branchynski/Bjack_with_gesture_control/model/matrix.png

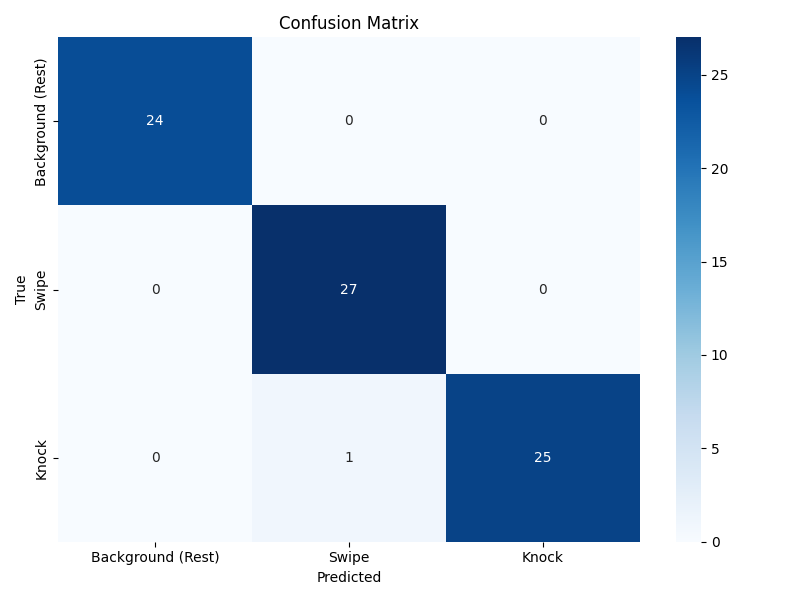
model/matrix.png
