branchynski/Bjack_with_gesture_control/model/ai_sensor_model/doc/ReleaseNotes.txt

Family       : artix7
Device       : xc7a35t
Package      : -cpg236
Speed Grade  : -1
Clock Period : 15.385
