branchynski/Bjack_with_gesture_control/rtl/ai/ml_sensor.v

// (c) Copyright 1986-2022 Xilinx, Inc. All Rights Reserved.
// (c) Copyright 2022-2026 Advanced Micro Devices, Inc. All rights reserved.
// 
// This file contains confidential and proprietary information
// of AMD and is protected under U.S. and international copyright
// and other intellectual property laws.
// 
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
// CRITICAL APPLICATIONS
// AMD products are not designed or intended to be fail-
// safe, or for use in any application requiring fail-safe
// performance, such as life-support or safety devices or
// systems, Class III medical devices, nuclear facilities,
// applications related to the deployment of airbags, or any
// other applications that could lead to death, personal
// injury, or severe property or environmental damage
// (individually and collectively, "Critical
// Applications"). Customer assumes the sole risk and
// liability of any use of AMD products in Critical
// Applications, subject only to applicable laws and
// regulations governing limitations on product liability.
// 
// THIS COPYRIGHT NOTICE AND DISCLAIMER MUST BE RETAINED AS
// PART OF THIS FILE AT ALL TIMES.
// 
// DO NOT MODIFY THIS FILE.


// IP VLNV: Bartlomiej_Raczynski:hls:myproject:1.0
// IP Revision: 2114630688

(* X_CORE_INFO = "myproject,Vivado 2025.1" *)
(* CHECK_LICENSE_TYPE = "ML_sensor,myproject,{}" *)
(* IP_DEFINITION_SOURCE = "HLS" *)
(* DowngradeIPIdentifiedWarnings = "yes" *)
module ML_sensor (
  input_layer_TDATA,
  input_layer_TREADY,
  input_layer_TVALID,
  layer15_out_TDATA,
  layer15_out_TREADY,
  layer15_out_TVALID,
  ap_clk,
  ap_rst_n,
  ap_done,
  ap_idle,
  ap_ready,
  ap_start
);

(* X_INTERFACE_INFO = "xilinx.com:interface:axis:1.0 input_layer TDATA" *)
(* X_INTERFACE_MODE = "slave" *)
(* X_INTERFACE_PARAMETER = "XIL_INTERFACENAME input_layer, TUSER_WIDTH 0, TDATA_NUM_BYTES 12, TDEST_WIDTH 0, TID_WIDTH 0, HAS_TREADY 1, HAS_TSTRB 0, HAS_TKEEP 0, HAS_TLAST 0, FREQ_HZ 100000000, PHASE 0.0, LAYERED_METADATA undef, INSERT_VIP 0" *)
input wire [95 : 0] input_layer_TDATA;
(* X_INTERFACE_INFO = "xilinx.com:interface:axis:1.0 input_layer TREADY" *)
output wire input_layer_TREADY;
(* X_INTERFACE_INFO = "xilinx.com:interface:axis:1.0 input_layer TVALID" *)
input wire input_layer_TVALID;
(* X_INTERFACE_INFO = "xilinx.com:interface:axis:1.0 layer15_out TDATA" *)
(* X_INTERFACE_MODE = "master" *)
(* X_INTERFACE_PARAMETER = "XIL_INTERFACENAME layer15_out, TUSER_WIDTH 0, TDATA_NUM_BYTES 6, TDEST_WIDTH 0, TID_WIDTH 0, HAS_TREADY 1, HAS_TSTRB 0, HAS_TKEEP 0, HAS_TLAST 0, FREQ_HZ 100000000, PHASE 0.0, LAYERED_METADATA undef, INSERT_VIP 0" *)
output wire [47 : 0] layer15_out_TDATA;
(* X_INTERFACE_INFO = "xilinx.com:interface:axis:1.0 layer15_out TREADY" *)
input wire layer15_out_TREADY;
(* X_INTERFACE_INFO = "xilinx.com:interface:axis:1.0 layer15_out TVALID" *)
output wire layer15_out_TVALID;
(* X_INTERFACE_INFO = "xilinx.com:signal:clock:1.0 ap_clk CLK" *)
(* X_INTERFACE_MODE = "slave" *)
(* X_INTERFACE_PARAMETER = "XIL_INTERFACENAME ap_clk, ASSOCIATED_BUSIF input_layer:layer15_out, ASSOCIATED_RESET ap_rst_n, FREQ_HZ 100000000, FREQ_TOLERANCE_HZ 0, PHASE 0.0, INSERT_VIP 0" *)
input wire ap_clk;
(* X_INTERFACE_INFO = "xilinx.com:signal:reset:1.0 ap_rst_n RST" *)
(* X_INTERFACE_MODE = "slave" *)
(* X_INTERFACE_PARAMETER = "XIL_INTERFACENAME ap_rst_n, POLARITY ACTIVE_LOW, INSERT_VIP 0" *)
input wire ap_rst_n;
(* X_INTERFACE_INFO = "xilinx.com:interface:acc_handshake:1.0 ap_ctrl done" *)
(* X_INTERFACE_MODE = "slave" *)
output wire ap_done;
(* X_INTERFACE_INFO = "xilinx.com:interface:acc_handshake:1.0 ap_ctrl idle" *)
output wire ap_idle;
(* X_INTERFACE_INFO = "xilinx.com:interface:acc_handshake:1.0 ap_ctrl ready" *)
output wire ap_ready;
(* X_INTERFACE_INFO = "xilinx.com:interface:acc_handshake:1.0 ap_ctrl start" *)
input wire ap_start;

(* SDX_KERNEL = "true" *)
(* SDX_KERNEL_TYPE = "hls" *)
(* SDX_KERNEL_SYNTH_INST = "inst" *)
  myproject inst (
    .input_layer_TDATA(input_layer_TDATA),
    .input_layer_TREADY(input_layer_TREADY),
    .input_layer_TVALID(input_layer_TVALID),
    .layer15_out_TDATA(layer15_out_TDATA),
    .layer15_out_TREADY(layer15_out_TREADY),
    .layer15_out_TVALID(layer15_out_TVALID),
    .ap_clk(ap_clk),
    .ap_rst_n(ap_rst_n),
    .ap_done(ap_done),
    .ap_idle(ap_idle),
    .ap_ready(ap_ready),
    .ap_start(ap_start)
  );
endmodule
