branchynski/Bjack_with_gesture_control/rtl/bjack_fsm/bjack_datapath.sv

/********************************************************************************
 * Module Name:    bjack_datapath
 * Date:           2026-06-04
 * Version:        2.1 (Master/Slave Massive-IF Architecture)
 * Description:    
 * Main datapath for the Blackjack game. 
 * If is_master == 1: Requests cards from LFSR, controls flow.
 * If is_master == 0: Passively accepts cards from UART and renders them.
 ********************************************************************************/

 module bjack_datapath (
    input  logic clk,
    input  logic rst_n,
    
    // --- OPERATING MODE SELECTION ---
    input  logic is_master,

    // --- Control signals from local FSM (Master only) ---
    input  logic sig_deal_enable, 
    input  logic sig_p0_turn,     
    input  logic sig_p1_turn,     
    input  logic sig_dealer_turn, 
    input  logic btn_p0_hit,      
    input  logic btn_p1_hit,      
    input  logic btn_start,       

    // --- Feedback signals to local FSM (Master only) ---
    output logic p0_bust,         
    output logic p1_bust,         
    output logic deal_done,
    output logic dealer_done,

    // --- Connection to local LFSR (Master only) ---
    input  logic [5:0] card_value,
    input  logic card_valid,
    output logic card_req,
    
    // --- Passive UART inputs (Slave only) ---
    input  logic uart_card_valid,
    input  logic [5:0] uart_card_val,
    input  logic [1:0] uart_card_dst, 
    input  logic uart_new_game,       

    // --- VGA Connection (Common) ---
    output logic [5:0] p0_cards [0:4],
    output logic [5:0] p1_cards [0:4],
    output logic [5:0] dealer_cards [0:4],
    output logic [2:0] p0_card_cnt,
    output logic [2:0] p1_card_cnt,
    output logic [2:0] dealer_card_cnt
);

    timeunit 1ns;
    timeprecision 1ps;

    import bjack_pkg::*;

    logic [2:0] init_deal_step; 
    logic req_pending;          
    
    // Final scores and Ace flags
    logic [5:0] p0_score, p1_score, d_score;
    logic p0_has_ace, p1_has_ace, d_has_ace;

    
    // EDGE DETECTORS 
    logic btn_p0_hit_prev, btn_p1_hit_prev;
    logic p0_hit_pulse, p1_hit_pulse;

    always_ff @(posedge clk or negedge rst_n) begin
        if (!rst_n) begin
            btn_p0_hit_prev <= 1'b0;
            btn_p1_hit_prev <= 1'b0;
        end else begin
            btn_p0_hit_prev <= btn_p0_hit;
            btn_p1_hit_prev <= btn_p1_hit;
        end
    end

    
    assign p0_hit_pulse = btn_p0_hit && !btn_p0_hit_prev;
    assign p1_hit_pulse = btn_p1_hit && !btn_p1_hit_prev;


    function automatic logic [3:0] get_points(input logic [5:0] c_val);
        logic [3:0] rank;
        rank = c_val % 13;
        if (rank == 0) return 4'd11;           
        else if (rank > 0 && rank < 10) return rank + 1; 
        else return 4'd10;                     
    endfunction

    always_ff @(posedge clk or negedge rst_n) begin
        if (!rst_n) begin
            p0_card_cnt <= '0;
            p1_card_cnt <= '0;
            dealer_card_cnt <= '0;
            init_deal_step  <= '0;
            card_req        <= 1'b0;
            req_pending     <= 1'b0;
            p0_bust         <= 1'b0;
            p1_bust         <= 1'b0;
            deal_done       <= 1'b0;
            dealer_done     <= 1'b0;
            
            for (int i=0; i<5; i++) begin
                p0_cards[i] <= '0;
                p1_cards[i] <= '0;
                dealer_cards[i] <= '0;
            end
        end else begin
            if (btn_start || (!is_master && uart_new_game)) begin
                p0_card_cnt <= '0;
                p1_card_cnt <= '0;
                dealer_card_cnt <= '0;
                init_deal_step  <= '0;
                p0_bust         <= 1'b0;
                p1_bust         <= 1'b0;
                deal_done       <= 1'b0;
                dealer_done     <= 1'b0;
                req_pending     <= 1'b0;
            end

            card_req <= 1'b0; 

            if (is_master) begin
                // --- 1. DEALING PHASE ---
                if (sig_deal_enable && !deal_done) begin
                    if (!req_pending && init_deal_step < 6) begin
                        card_req <= 1'b1;
                        req_pending <= 1'b1;
                    end
                    
                    if (card_valid && req_pending) begin
                        req_pending <= 1'b0;
                        if (init_deal_step == 0 || init_deal_step == 3) begin
                            p0_cards[p0_card_cnt] <= card_value; p0_card_cnt <= p0_card_cnt + 1;
                        end else if (init_deal_step == 1 || init_deal_step == 4) begin
                            p1_cards[p1_card_cnt] <= card_value; p1_card_cnt <= p1_card_cnt + 1;
                        end else begin
                            dealer_cards[dealer_card_cnt] <= card_value; dealer_card_cnt <= dealer_card_cnt + 1;
                        end
                        init_deal_step <= init_deal_step + 1;
                    end
                    if (init_deal_step == 6) deal_done <= 1'b1;
                end

                // --- 2. PLAYER 0 TURN ---
                if (sig_p0_turn) begin
                    if (p0_hit_pulse && !req_pending && p0_card_cnt < 5) begin
                        card_req <= 1'b1; req_pending <= 1'b1;
                    end
                    if (card_valid && req_pending) begin
                        req_pending <= 1'b0; p0_cards[p0_card_cnt] <= card_value; p0_card_cnt <= p0_card_cnt + 1;
                    end
                    if (p0_score > 21) p0_bust <= 1'b1;
                end

                // --- 3. PLAYER 1 TURN ---
                if (sig_p1_turn) begin
                    if (p1_hit_pulse && !req_pending && p1_card_cnt < 5) begin
                        card_req <= 1'b1; req_pending <= 1'b1;
                    end
                    if (card_valid && req_pending) begin
                        req_pending <= 1'b0; p1_cards[p1_card_cnt] <= card_value; p1_card_cnt <= p1_card_cnt + 1;
                    end
                    
                    if (p1_score > 21) p1_bust <= 1'b1;
                end

                // --- 4. DEALER TURN ---
                if (sig_dealer_turn && !dealer_done) begin
                    if (d_score < 17 && dealer_card_cnt < 5) begin
                        if (!req_pending) begin
                            card_req <= 1'b1; req_pending <= 1'b1;
                        end
                        if (card_valid && req_pending) begin
                            req_pending <= 1'b0; dealer_cards[dealer_card_cnt] <= card_value; dealer_card_cnt <= dealer_card_cnt + 1;
                        end
                    end else if (!req_pending) begin 
                        dealer_done <= 1'b1;
                    end
                end

            end else begin
                // --- SLAVE MODE ---
                card_req <= 1'b0;
                req_pending <= 1'b0;
                
                if (uart_card_valid) begin
                    case (uart_card_dst)
                        2'd0: begin if (p0_card_cnt < 5) begin p0_cards[p0_card_cnt] <= uart_card_val; p0_card_cnt <= p0_card_cnt + 1; end end
                        2'd1: begin if (p1_card_cnt < 5) begin p1_cards[p1_card_cnt] <= uart_card_val; p1_card_cnt <= p1_card_cnt + 1; end end
                        2'd2: begin if (dealer_card_cnt < 5) begin dealer_cards[dealer_card_cnt] <= uart_card_val; dealer_card_cnt <= dealer_card_cnt + 1; end end
                    endcase
                end
            end
        end
    end

   
    // Immediate Point Calculation
    logic [5:0] p0_raw, p1_raw, d_raw;
    
    always_comb begin
        p0_raw = '0; p0_has_ace = 1'b0;
        p1_raw = '0; p1_has_ace = 1'b0;
        d_raw = '0;  d_has_ace = 1'b0;

        for (int i = 0; i < 5; i++) begin
            if (i < p0_card_cnt) begin
                p0_raw = p0_raw + get_points(p0_cards[i]);
                if (p0_cards[i] % 13 == 0) p0_has_ace = 1'b1;
            end
            if (i < p1_card_cnt) begin
                p1_raw = p1_raw + get_points(p1_cards[i]);
                if (p1_cards[i] % 13 == 0) p1_has_ace = 1'b1;
            end
            if (i < dealer_card_cnt) begin
                d_raw = d_raw + get_points(dealer_cards[i]);
                if (dealer_cards[i] % 13 == 0) d_has_ace = 1'b1;
            end
        end

        // HARDWARE MULTIPLEXER: Changing Ace value on the fly
        p0_score = (p0_has_ace && p0_raw > 21) ? p0_raw - 10 : p0_raw;
        p1_score = (p1_has_ace && p1_raw > 21) ? p1_raw - 10 : p1_raw;
        d_score  = (d_has_ace  && d_raw  > 21) ? d_raw  - 10 : d_raw;
    end

endmodule
