branchynski/Bjack_with_gesture_control/rtl/gesture_monitor.sv

/**
 * Module name:   gesture_monitor
 * Author:        Bartłomiej Raczyński
 * Version:       1.0
 * Last modified: 2026-06-07
 * Description:  module for monitoring the output of the gesture recognition system. 
 * It takes the current gesture as input and drives a set of LEDs to 
 * indicate which gesture is currently recognized. 
 */

import ai_type_pkg::*;

module gesture_monitor (
    input  logic clk,
    input  logic rst_n,
    input  gesture_out current_gesture,

    output logic [2:0] leds
);

    logic [2:0] leds_nxt;

    always_ff @(posedge clk or negedge rst_n) begin
        if (!rst_n) begin
            leds <= '0;
        end else begin
            leds <= leds_nxt;
        end
    end

    always_comb begin
        case (current_gesture)
            NOTHING:       leds_nxt = 3'b001;
            SWIPE_RIGHT: leds_nxt = 3'b010;
            KNOCK:  leds_nxt = 3'b100;
            default:     leds_nxt = 3'b000;
        endcase
    end

endmodule
