branchynski/Bjack_with_gesture_control/rtl/bjack_fsm/bjack_pkg.sv

/********************************************************************************
 * Package Name:   bjack_pkg
 * Author:         Eryk Rutka
 * Date:           2026-06-02
 * Version:        1.2 (Multiplayer Update)
 * * Description:   
 * This package contains data types, parameters for card game.
 ********************************************************************************/

 package bjack_pkg;

    /* bjack_fsm  */
        typedef enum logic [2:0] {
            IDLE, 
            DEAL_INITIAL, 
            P0_TURN,       
            P1_TURN,    
            DEALER_TURN, 
            EVALUATE, 
            GAME_OVER
        } fsm_state_t;
    
       
        localparam logic [4:0] MAX_SCORE    = 5'd21; 
        localparam logic [4:0] DEALER_STAND = 5'd17; 
    
        /*card_drawing*/
        localparam logic [5:0] CARD_DECK = 6'd54;
    
        localparam logic [15:0] MONEY = 16'd100; 
    endpackage
