branchynski/Bjack_with_gesture_control/rtl/vga/vga_if.sv

/********************************************************************************
 * Module Name:    vga_if
 * Author:         Eryk Rutka
 * Date:           2026-05-31
 * Version:        1.0
 * Description:    
 * VGA interface.
 ********************************************************************************/
interface vga_if; 

    logic [10:0] hcount;
    logic hsync;
    logic hblnk;
    logic [10:0] vcount;
    logic vsync;
    logic vblnk;
    logic [11:0] rgb;

    modport in ( 
        input vcount,
        input vsync,
        input vblnk,
        input hcount,
        input hsync,
        input hblnk,
        input rgb
    );

    modport out (
        output vcount,
        output vsync,
        output vblnk,
        output hcount,
        output hsync,
        output hblnk,
        output rgb
    );

endinterface
