branchynski/Bjack_with_gesture_control/(commit log)

2026-05-07 feat() sensor communication
2026-05-07 fix(): output for sensor
    [lsm6dso_ctrl.sv]
2026-05-18 fix reduce model and improve it for BASYS 3'
    [convert_to_fpga.py, model.py]
2026-05-30 fix fsm for ai and test it
    [knock.csv]
2026-05-30 fix errors with synthesis ai model
    [top_vga_basys3.sv]
2026-05-31 table and comments fix
    [draw_bg.sv, top_menu.sv, top_vga.sv, vga_pkg.sv, vga_timing.sv]
2026-06-04 preparing for uart
2026-06-04 added uart protocol control
2026-06-06 fix errros and implement project to the board
    [gesture_monitor.sv, lsm6dso_ctrl.sv, spi_ce_gen.sv, top_game.sv, top_vga.sv, top_vga_basys3.sv]
2026-06-07 fix new model with input fixed number not int
    [convert_to_fpga.py]
2026-06-08 fix ai model and improve it
    [swiper.csv]
2026-06-11 fix ai problems with recognise gesture
    [model_controller_fsm.sv, sliding_window_buffer.sv, top_gesture.sv]
2026-06-13 top vga freeze fix (probably)(syzyf)
    [draw_start.sv, top_menu.sv, top_vga_tb.sv, uart_protocol_ctrl.sv]
2026-06-13 fixed strings display in game menu
    [top_menu.sv]
2026-06-14 fixed top vga for game over menu handling
    [top_vga.sv]
2026-06-14 fixed game design, fixed vga testbench, other game fixes
    [card_generator.sv, draw_credits.sv, draw_game_over.sv, top_menu.sv, top_vga.sv, top_vga_tb.sv]
